yswallow/satsuma_keyboard/README.md

### Satsuma JP SMD

#### 組み立てに必要なもの
* MX互換スイッチ 67個
* ARCHISS キーキャップセット 1セット

#### 各部名称

#### 組み立て方
1. キースイッチをトッププレートにはめる。この際上下が逆になっているキーがあるので注意する。
2. キースイッチがはまった状態のトッププレートを本体にはめる。
3. キースイッチにキーキャップをはめる。
4. 完成！
