yswallow/satsuma_keyboard/docs/warranty.md

### 交換保証

購入後1ヶ月以内に故障した場合代品と交換致しますが, そちらからの送料はご負担ください。

#### 交換対象
* はんだづけされているパーツの不良によるキーが反応しなくなる症状全般

#### 除外
* トッププレートの割れ
* ファームウェアが書き換えられている場合で, はんだづけ不良が原因であると確認できない場合

#### 送付方法
~~キーキャップとキースイッチを取り外し, 動作不良のモジュールとpendantを送付ください。~~

メールでご案内します。

#### 限定
こちらでの確認でファームウェアの書き換えが原因と判明した場合, 返送料をご負担いただきます。
