yswallow/satsuma_keyboard/PCB/left/left-PCB.kicad_pcb

## KiCad design PCB/left/left-PCB.kicad_pcb (2019-07-09)

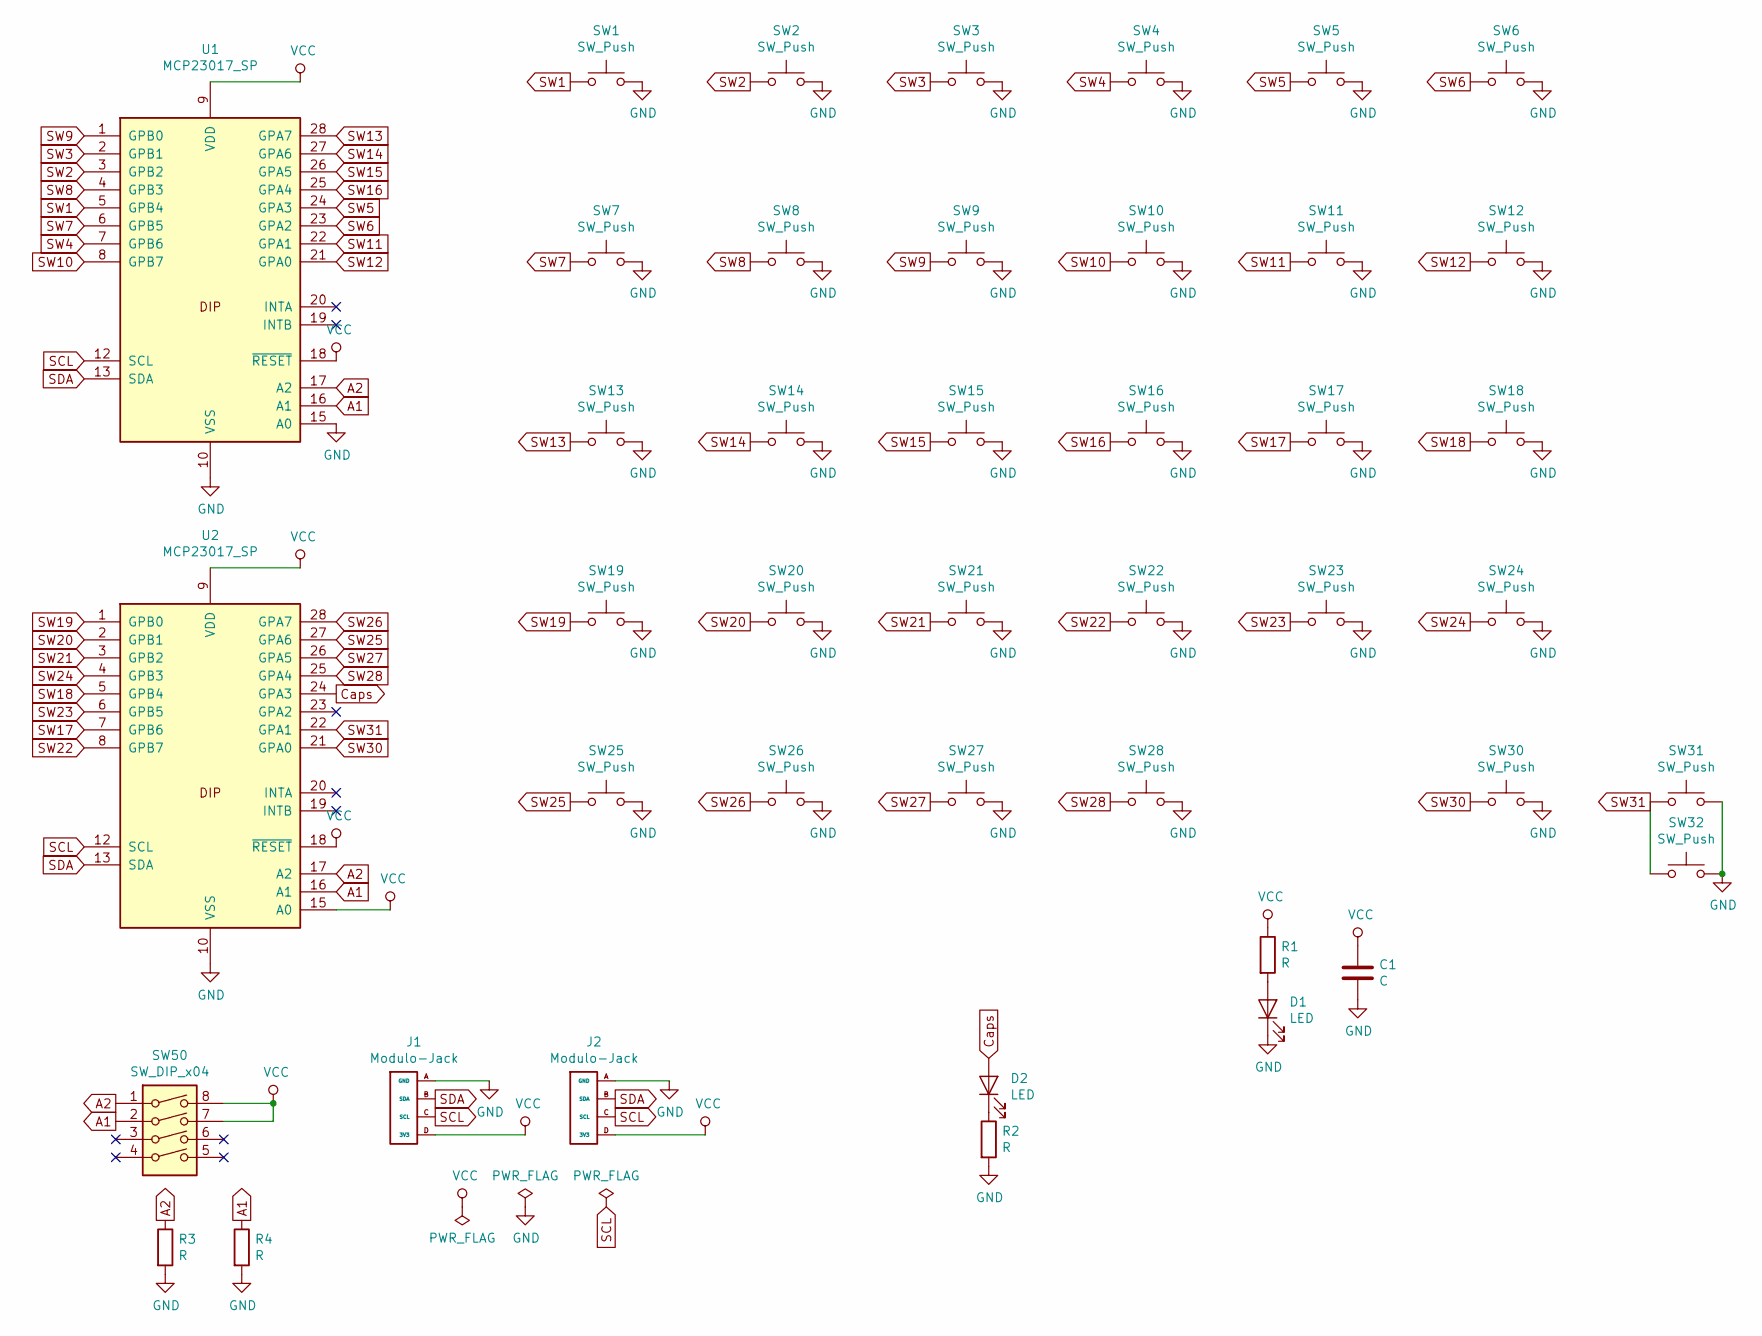
[picture p1: schematic left-PCB.sch]

Parts:
C1: C; C_2225_5664Metric_Pad1.80x6.60mm_HandSolder
D1, D2: LED; LED_D3.0mm
J1, J2: Modulo-Jack; PJ-320D
R1, R2, R3, R4: R; R_Axial_DIN0207_L6.3mm_D2.5mm_P10.16mm_Horizontal
SW1, SW2, SW3, SW4, SW5, SW6, SW8, SW9, SW10, SW11, SW12, SW14, SW15, SW16, SW17, SW18, SW20, SW21, SW22, SW23, SW24, SW26, SW28, SW30, SW31: SW_Push; MXOnly-1U-Hotswap
SW7: SW_Push; MXOnly-1.5U-Hotswap
SW13: SW_Push; MXOnly-1.75U-Hotswap
SW19: SW_Push; MXOnly-2.25U-Hotswap
SW25, SW27: SW_Push; MXOnly-1.25U-Hotswap
SW32: SW_Push; MXOnly-2U-Hotswap-ReversedStabilizers
SW50: SW_DIP_x04; KHS42
U1, U2: MCP23017_SP; SOIC-28W_7.5x17.9mm_P1.27mm

Connections:
A1: R4.1, SW50.2, U1.16 (A1), U2.16 (A1)
A2: R3.1, SW50.1, U1.17 (A2), U2.17 (A2)
Caps: D2.2 (A), U2.24 (GPA3)
GND: C1.2, D1.1 (K), J1.A (GND), J2.A (GND), R2.2, R3.2, R4.2, SW1.1, SW2.1, SW3.2, SW4.2, SW5.2, SW6.2, SW7.1, SW8.1, SW9.2, SW10.2, SW11.2, SW12.2, SW13.2, SW14.2, SW15.1, SW16.1, SW17.2, SW18.1, SW19.1, SW20.2, SW21.2, SW22.2, SW23.2, SW24.2, SW25.1, SW26.1, SW27.2, SW28.1, SW30.1, SW31.1, SW32.1, U1.10 (VSS), U1.15 (A0), U2.10 (VSS)
unnamed: D1.2 (A), R1.2
unnamed: D2.1 (K), R2.1
SCL: J1.C (SCL), J2.C (SCL), U1.12 (SCL), U2.12 (SCL)
SDA: J1.B (SDA), J2.B (SDA), U1.13 (SDA), U2.13 (SDA)
SW1: SW1.2, U1.5 (GPB4)
SW2: SW2.2, U1.3 (GPB2)
SW3: SW3.1, U1.2 (GPB1)
SW4: SW4.1, U1.7 (GPB6)
SW5: SW5.1, U1.24 (GPA3)
SW6: SW6.1, U1.23 (GPA2)
SW7: SW7.2, U1.6 (GPB5)
SW8: SW8.2, U1.4 (GPB3)
SW9: SW9.1, U1.1 (GPB0)
SW10: SW10.1, U1.8 (GPB7)
SW11: SW11.1, U1.22 (GPA1)
SW12: SW12.1, U1.21 (GPA0)
SW13: SW13.1, U1.28 (GPA7)
SW14: SW14.1, U1.27 (GPA6)
SW15: SW15.2, U1.26 (GPA5)
SW16: SW16.2, U1.25 (GPA4)
SW17: SW17.1, U2.7 (GPB6)
SW18: SW18.2, U2.5 (GPB4)
SW19: SW19.2, U2.1 (GPB0)
SW20: SW20.1, U2.2 (GPB1)
SW21: SW21.1, U2.3 (GPB2)
SW22: SW22.1, U2.8 (GPB7)
SW23: SW23.1, U2.6 (GPB5)
SW24: SW24.1, U2.4 (GPB3)
SW25: SW25.2, U2.27 (GPA6)
SW26: SW26.2, U2.28 (GPA7)
SW27: SW27.1, U2.26 (GPA5)
SW28: SW28.2, U2.25 (GPA4)
SW30: SW30.2, U2.21 (GPA0)
SW31: SW31.2, SW32.2, U2.22 (GPA1)
VCC: C1.1, J1.D (3V3), J2.D (3V3), R1.1, SW50.7, SW50.8, U1.9 (VDD), U1.18 (~RESET~), U2.9 (VDD), U2.15 (A0), U2.18 (~RESET~)

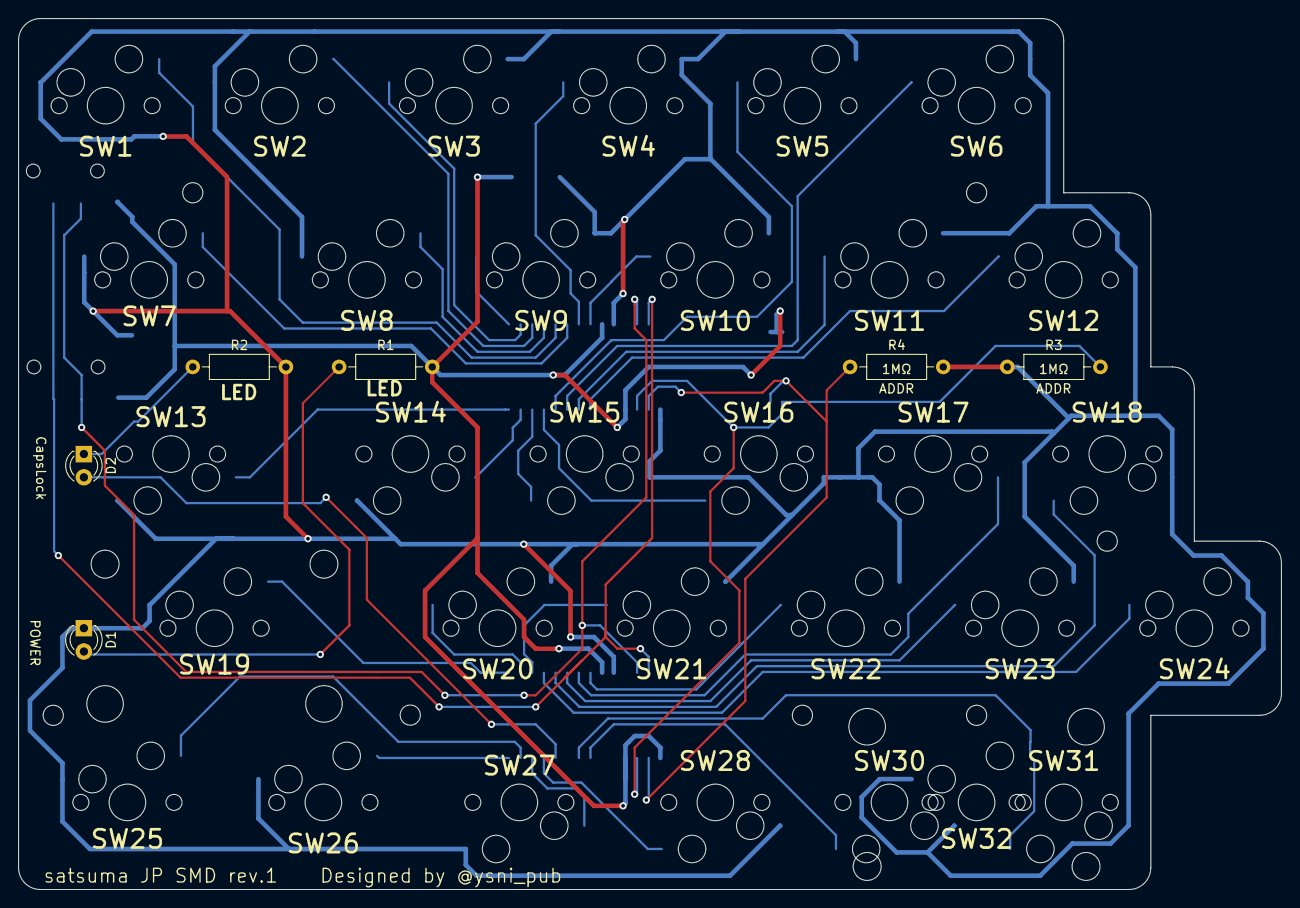
[picture p2: board left-PCB.kicad_pcb from above]

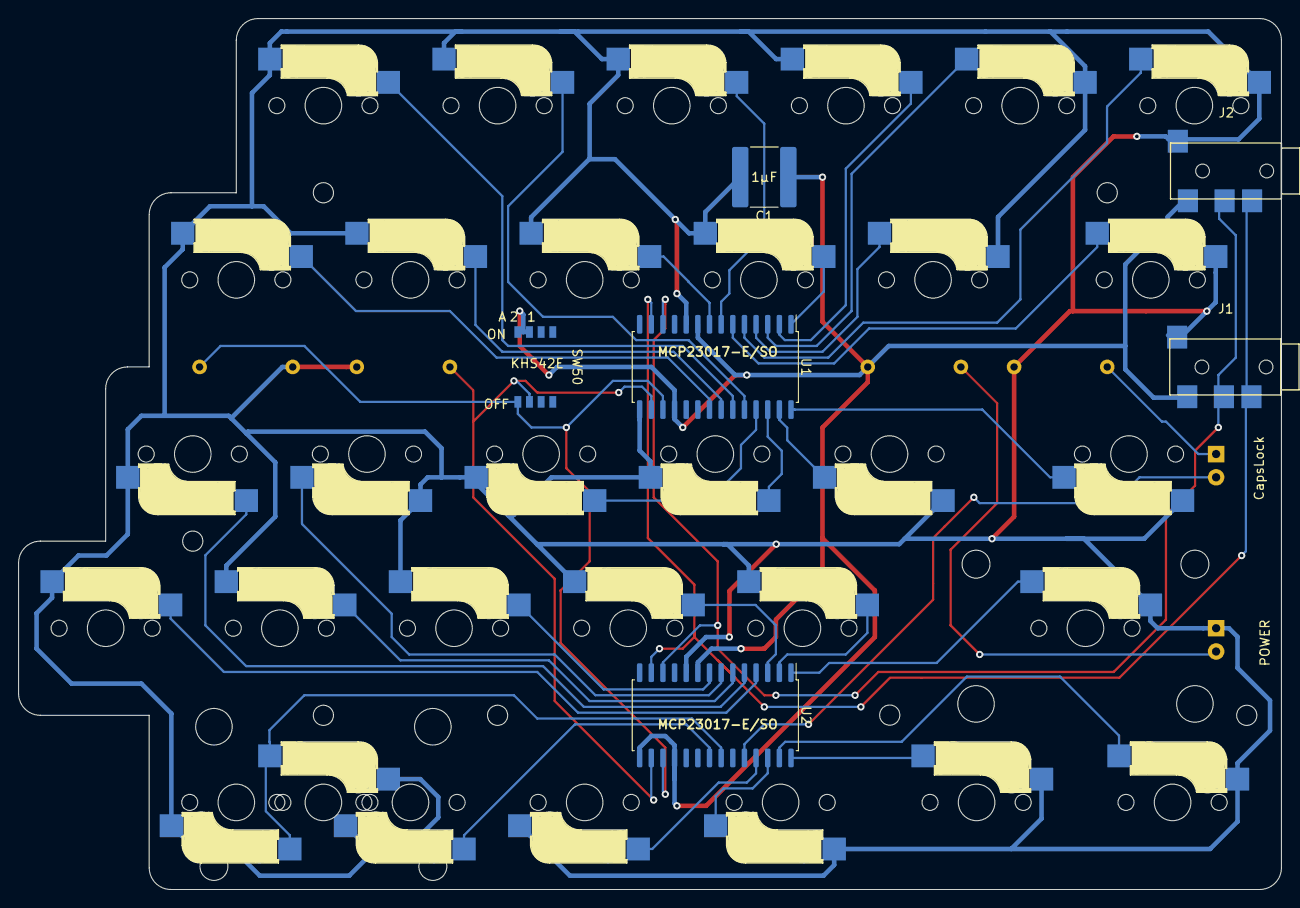
[picture p3: board left-PCB.kicad_pcb from below]

Board: 2 copper layers, 137.8 x 95.0 mm, 43 parts (6 on the bottom side), 39 nets.
