yswallow/satsuma_keyboard/PCB/right/right-PCB.kicad_pcb

## KiCad design PCB/right/right-PCB.kicad_pcb (2019-07-09)

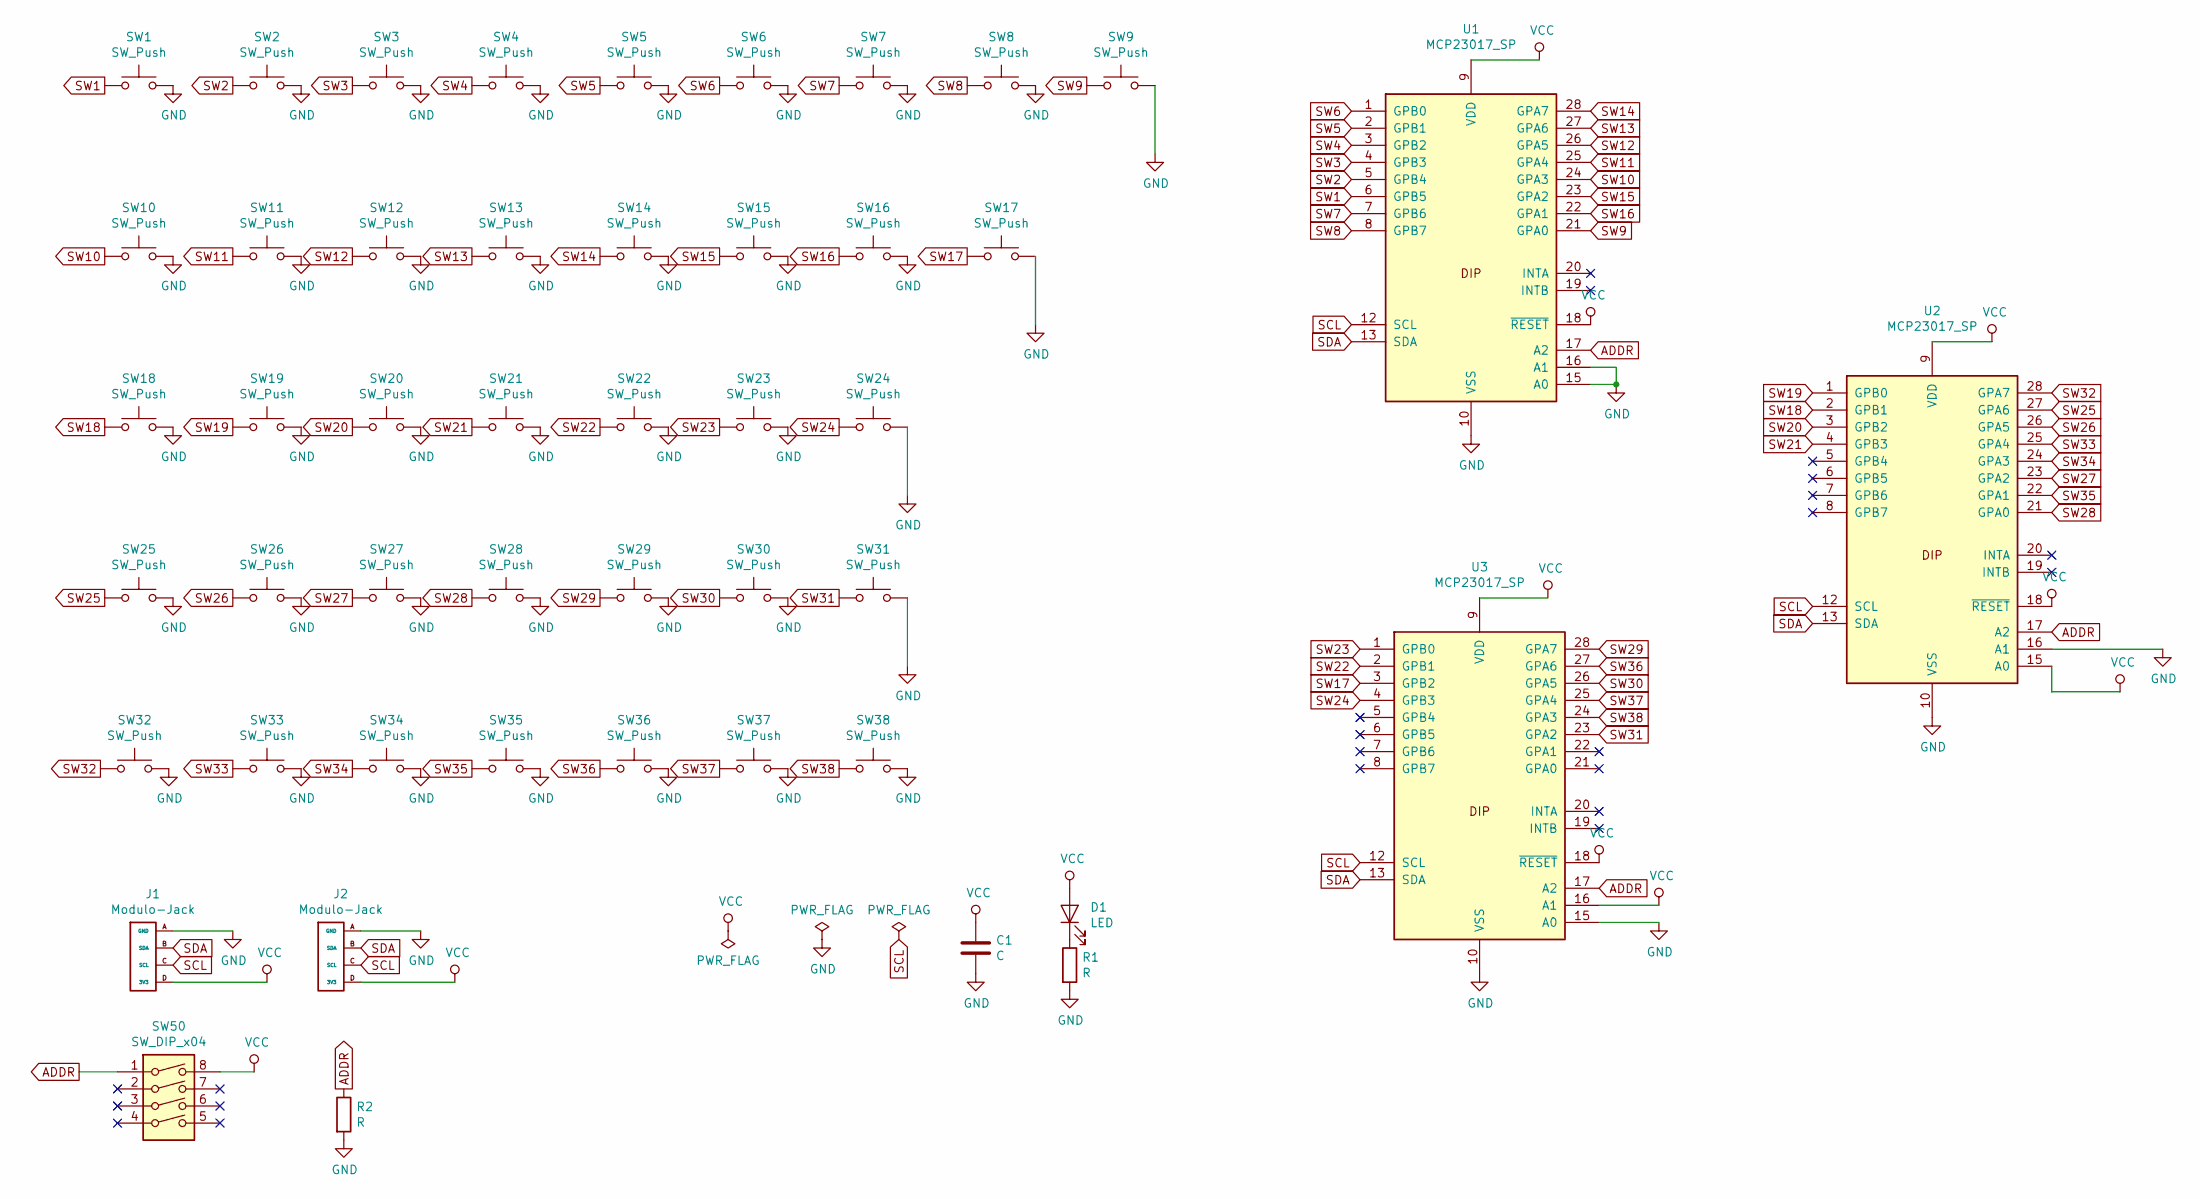
[picture p4: schematic right-PCB.sch]

Parts:
C1: C; C_2220_5650Metric_Pad1.97x5.40mm_HandSolder
D1: LED; LED_D3.0mm
J1, J2: Modulo-Jack; PJ-320D
R1, R2: R; R_Axial_DIN0207_L6.3mm_D2.5mm_P10.16mm_Horizontal
SW1, SW2, SW3, SW4, SW5, SW6, SW7, SW8, SW9, SW10, SW11, SW12, SW13, SW14, SW15, SW16, SW18, SW19, SW20, SW21, SW22, SW23, SW24, SW25, SW26, SW27, SW28, SW29, SW30, SW32, SW33, SW37: SW_Push; MXOnly-1U-Hotswap
SW17: SW_Push; MXOnly-ISO-HotSwap
SW31: SW_Push; MXOnly-1.75U-Hotswap
SW34, SW35, SW36, SW38: SW_Push; MXOnly-1.25U-Hotswap
SW50: SW_DIP_x04; KHS42
U1, U2, U3: MCP23017_SP; SOIC-28W_7.5x17.9mm_P1.27mm

Connections:
ADDR: R2.1, SW50.1, U1.17 (A2), U2.17 (A2), U3.17 (A2)
GND: C1.2, J1.A (GND), J2.A (GND), R1.2, R2.2, SW1.1, SW2.2, SW3.2, SW4.2, SW5.2, SW6.2, SW7.2, SW8.2, SW9.2, SW10.2, SW11.2, SW12.2, SW13.2, SW14.2, SW15.2, SW16.1, SW17.1, SW18.1, SW19.1, SW20.1, SW21.2, SW22.2, SW23.2, SW24.2, SW25.2, SW26.2, SW27.1, SW28.1, SW29.2, SW30.1, SW31.2, SW32.1, SW33.1, SW34.2, SW35.2, SW36.2, SW37.2, SW38.1, U1.10 (VSS), U1.15 (A0), U1.16 (A1), U2.10 (VSS), U2.16 (A1), U3.10 (VSS), U3.15 (A0)
unnamed: D1.1 (K), R1.1
SCL: J1.C (SCL), J2.C (SCL), U1.12 (SCL), U2.12 (SCL), U3.12 (SCL)
SDA: J1.B (SDA), J2.B (SDA), U1.13 (SDA), U2.13 (SDA), U3.13 (SDA)
SW1: SW1.2, U1.6 (GPB5)
SW2: SW2.1, U1.5 (GPB4)
SW3: SW3.1, U1.4 (GPB3)
SW4: SW4.1, U1.3 (GPB2)
SW5: SW5.1, U1.2 (GPB1)
SW6: SW6.1, U1.1 (GPB0)
SW7: SW7.1, U1.7 (GPB6)
SW8: SW8.1, U1.8 (GPB7)
SW9: SW9.1, U1.21 (GPA0)
SW10: SW10.1, U1.24 (GPA3)
SW11: SW11.1, U1.25 (GPA4)
SW12: SW12.1, U1.26 (GPA5)
SW13: SW13.1, U1.27 (GPA6)
SW14: SW14.1, U1.28 (GPA7)
SW15: SW15.1, U1.23 (GPA2)
SW16: SW16.2, U1.22 (GPA1)
SW17: SW17.2, U3.3 (GPB2)
SW18: SW18.2, U2.2 (GPB1)
SW19: SW19.2, U2.1 (GPB0)
SW20: SW20.2, U2.3 (GPB2)
SW21: SW21.1, U2.4 (GPB3)
SW22: SW22.1, U3.2 (GPB1)
SW23: SW23.1, U3.1 (GPB0)
SW24: SW24.1, U3.4 (GPB3)
SW25: SW25.1, U2.27 (GPA6)
SW26: SW26.1, U2.26 (GPA5)
SW27: SW27.2, U2.23 (GPA2)
SW28: SW28.2, U2.21 (GPA0)
SW29: SW29.1, U3.28 (GPA7)
SW30: SW30.2, U3.26 (GPA5)
SW31: SW31.1, U3.23 (GPA2)
SW32: SW32.2, U2.28 (GPA7)
SW33: SW33.2, U2.25 (GPA4)
SW34: SW34.1, U2.24 (GPA3)
SW35: SW35.1, U2.22 (GPA1)
SW36: SW36.1, U3.27 (GPA6)
SW37: SW37.1, U3.25 (GPA4)
SW38: SW38.2, U3.24 (GPA3)
VCC: C1.1, D1.2 (A), J1.D (3V3), J2.D (3V3), SW50.8, U1.9 (VDD), U1.18 (~RESET~), U2.9 (VDD), U2.15 (A0), U2.18 (~RESET~), U3.9 (VDD), U3.16 (A1), U3.18 (~RESET~)

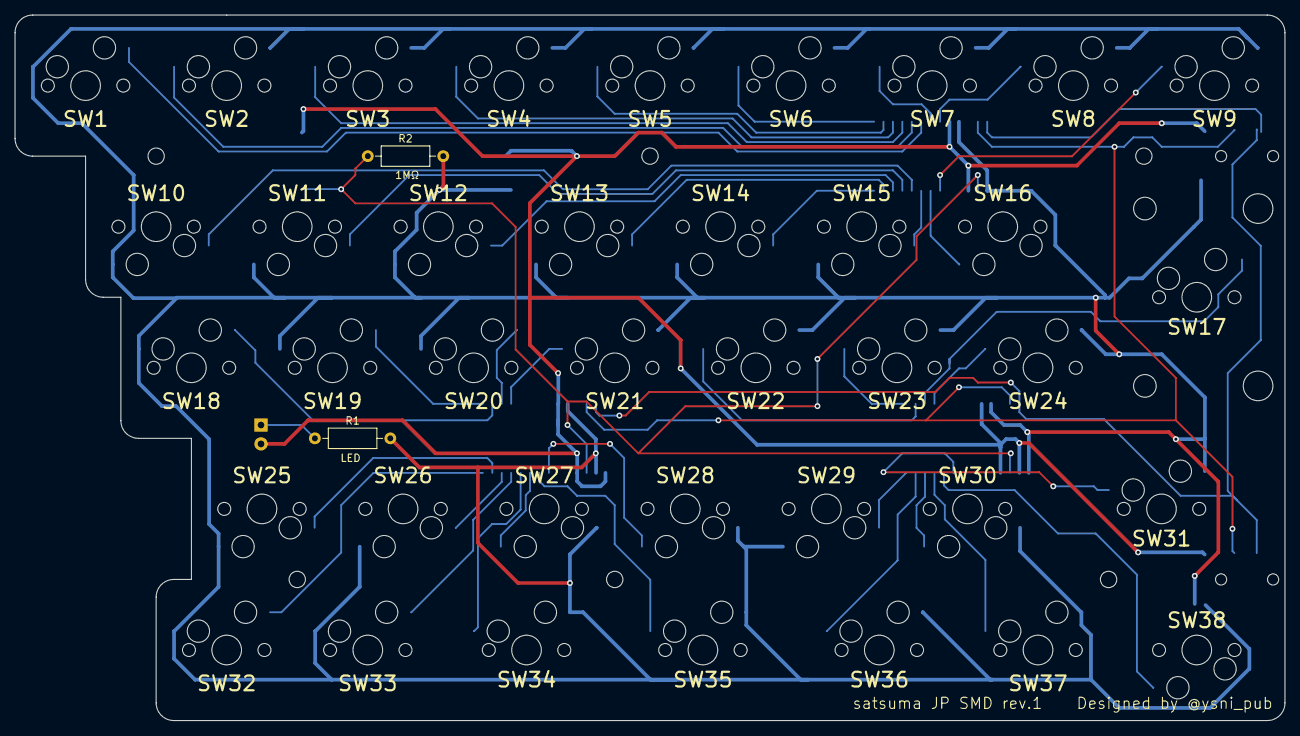
[picture p5: board right-PCB.kicad_pcb from above]

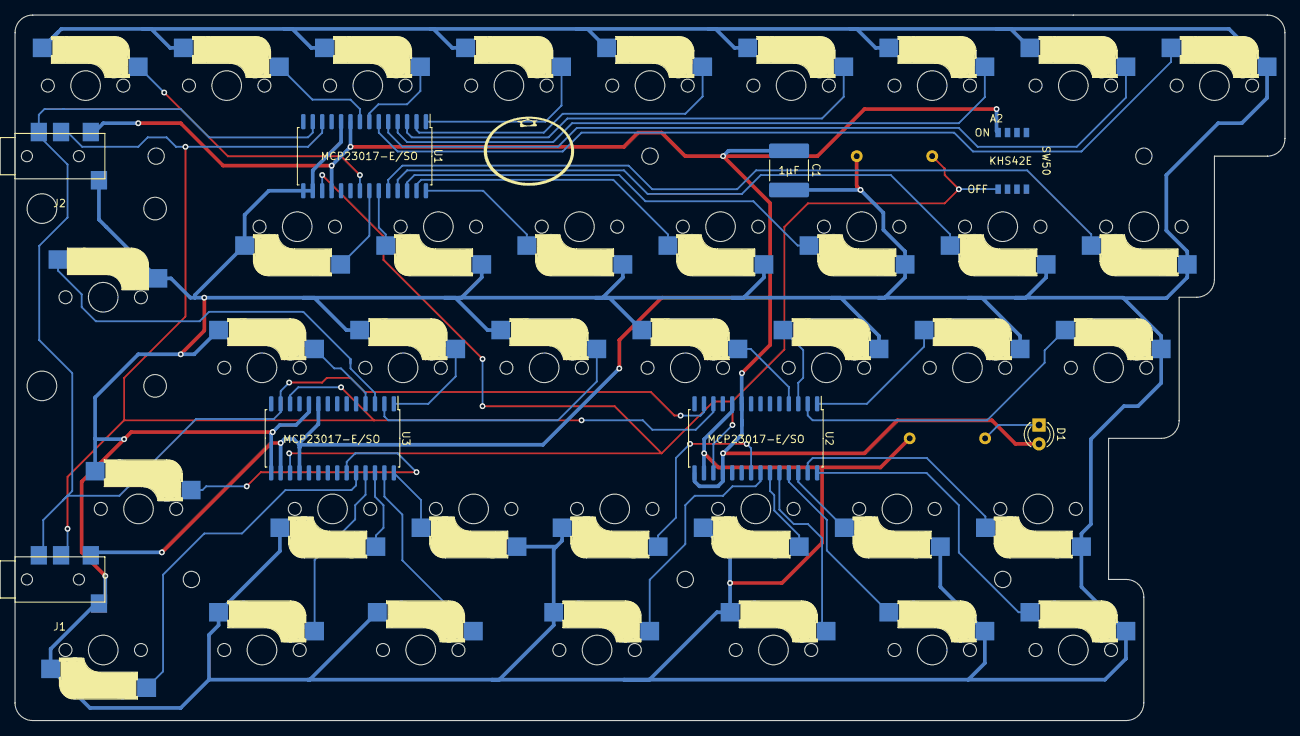
[picture p6: board right-PCB.kicad_pcb from below]

Board: 2 copper layers, 171.0 x 95.0 mm, 48 parts (8 on the bottom side), 44 nets.
