yswallow/satsuma_keyboard/left/left.kicad_pcb

## KiCad design left/left.kicad_pcb (2019-06-07)

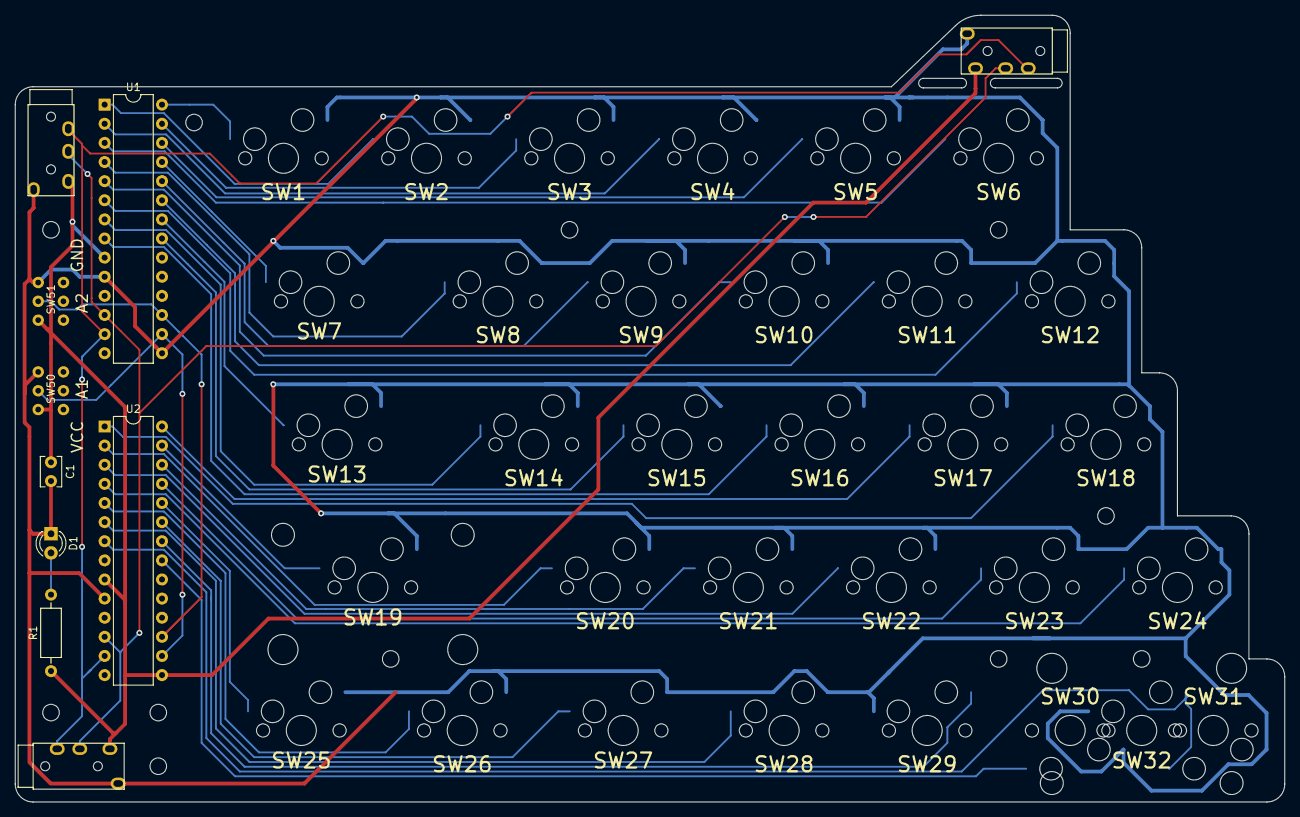
[picture p7: board left.kicad_pcb from above]

Board: 2 copper layers, 168.6 x 104.5 mm, 42 parts (0 on the bottom side), 38 nets.

Parts:
C1: C; C_Disc_D3.8mm_W2.6mm_P2.50mm
D1: LED; LED_D3.0mm
J1, J2, J3: Modulo-Jack; MJ-4PP-9
R1: R; R_Axial_DIN0207_L6.3mm_D2.5mm_P10.16mm_Horizontal
SW1, SW2, SW3, SW4, SW5, SW6, SW8, SW9, SW10, SW11, SW12, SW14, SW15, SW16, SW17, SW18, SW20, SW21, SW22, SW23, SW24, SW26, SW28, SW29, SW30, SW31: SW_Push; MXOnly-1U-Hotswap
SW7: SW_Push; MXOnly-1.5U-Hotswap
SW13: SW_Push; MXOnly-1.75U-Hotswap
SW19: SW_Push; MXOnly-2.25U-Hotswap
SW25, SW27: SW_Push; MXOnly-1.25U-Hotswap
SW32: SW_Push; MXOnly-2U-Hotswap-ReversedStabilizers
SW50, SW51: SW_DPDT_x2; SlideSwitch_IS2235
U1, U2: MCP23017_SP; DIP-28_W7.62mm

Connections:
A1: SW50.2, U1.16, U2.16
A2: SW51.2, U1.17, U2.17
GND: C1.2, D1.1, J1.A, J2.A, J3.A, SW1.2, SW2.2, SW3.2, SW4.2, SW5.2, SW6.2, SW7.2, SW8.2, SW9.2, SW10.2, SW11.2, SW12.2, SW13.2, SW14.2, SW15.2, SW16.2, SW17.2, SW18.2, SW19.2, SW20.2, SW21.2, SW22.2, SW23.2, SW24.2, SW25.2, SW26.2, SW27.2, SW28.2, SW29.1, SW30.1, SW31.1, SW32.1, SW50.3, SW51.3, U1.10, U1.15, U2.10
unnamed: D1.2, R1.2
SCL: J1.C, J2.C, J3.C, U1.12, U2.12
SDA: J1.B, J2.B, J3.B, U1.13, U2.13
SW1: SW1.1, U1.28
SW2: SW2.1, U1.1
SW3: SW3.1, U1.27
SW4: SW4.1, U1.2
SW5: SW5.1, U1.26
SW6: SW6.1, U1.3
SW7: SW7.1, U1.25
SW8: SW8.1, U1.4
SW9: SW9.1, U1.24
SW10: SW10.1, U1.5
SW11: SW11.1, U1.23
SW12: SW12.1, U1.6
SW13: SW13.1, U1.22
SW14: SW14.1, U1.7
SW15: SW15.1, U1.21
SW16: SW16.1, U1.8
SW17: SW17.1, U2.28
SW18: SW18.1, U2.1
SW19: SW19.1, U2.27
SW20: SW20.1, U2.2
SW21: SW21.1, U2.26
SW22: SW22.1, U2.3
SW23: SW23.1, U2.25
SW24: SW24.1, U2.4
SW25: SW25.1, U2.24
SW26: SW26.1, U2.5
SW27: SW27.1, U2.23
SW28: SW28.1, U2.6
SW29: SW29.2, U2.22
SW30: SW30.2, U2.21
SW31: SW31.2, SW32.2, U2.7
VCC: C1.1, J1.D, J2.D, J3.D, R1.1, SW50.1, SW51.1, U1.9, U2.9, U2.15
