yswallow/satsuma_keyboard/right/right.kicad_pcb

## KiCad design right/right.kicad_pcb (2019-06-06)

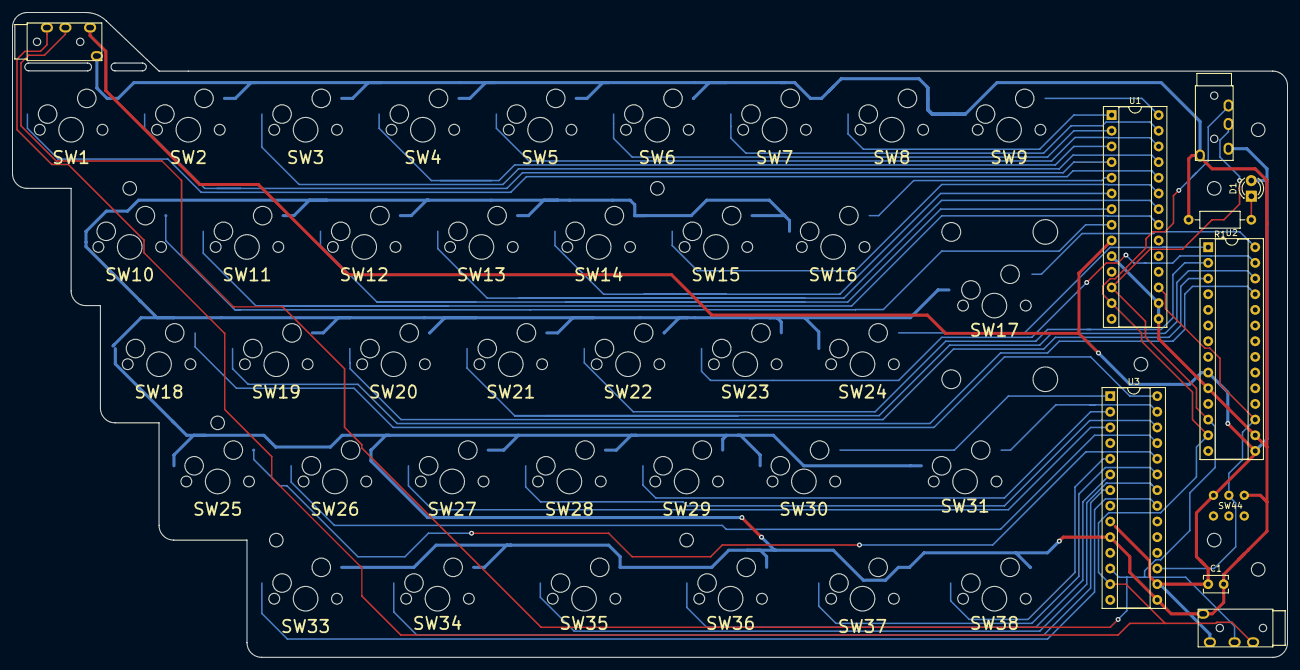
[picture p8: board right.kicad_pcb from above]

Board: 2 copper layers, 206.6 x 104.5 mm, 47 parts (0 on the bottom side), 43 nets.

Parts:
C1: C; C_Disc_D3.8mm_W2.6mm_P2.50mm
D1: LED; LED_D3.0mm
J1, J2, J3: Modulo-Jack; MJ-4PP-9
R1: R; R_Axial_DIN0207_L6.3mm_D2.5mm_P10.16mm_Horizontal
SW1, SW2, SW3, SW4, SW5, SW6, SW7, SW8, SW9, SW10, SW11, SW12, SW13, SW14, SW15, SW16, SW18, SW19, SW20, SW21, SW22, SW23, SW24, SW25, SW26, SW27, SW28, SW29, SW30, SW33, SW37: SW_Push; MXOnly-1U-Hotswap
SW17: SW_Push; MXOnly-ISO-HotSwap
SW31: SW_Push; MXOnly-1.75U-Hotswap
SW34, SW35, SW36, SW38: SW_Push; MXOnly-1.25U-Hotswap
SW44: SW_DPDT_x2; SlideSwitch_IS2235
U1, U2, U3: MCP23017_SP; DIP-28_W7.62mm_Socket

Connections:
ADDR: SW44.2, U1.17, U2.17, U3.17
GND: C1.2, J1.A, J2.A, J3.A, R1.2, SW1.2, SW2.2, SW3.2, SW4.2, SW5.2, SW6.2, SW7.2, SW8.2, SW9.1, SW10.1, SW11.2, SW12.2, SW13.2, SW14.2, SW15.2, SW16.1, SW17.1, SW18.1, SW19.2, SW20.2, SW21.2, SW22.2, SW23.2, SW24.1, SW25.1, SW26.2, SW27.2, SW28.2, SW29.2, SW30.1, SW31.1, SW33.2, SW34.2, SW35.2, SW36.2, SW37.2, SW38.2, SW44.3, U1.10, U1.15, U1.16, U2.10, U2.16, U3.10, U3.15
unnamed: D1.1, R1.1
SCK: J1.C, J2.C, J3.C, U1.12, U2.12, U3.12
SDA: J1.B, J2.B, J3.B, U1.13, U2.13, U3.13
SW1: SW1.1, U1.24
SW2: SW2.1, U1.4
SW3: SW3.1, U1.25
SW4: SW4.1, U1.3
SW5: SW5.1, U1.26
SW6: SW6.1, U1.2
SW7: SW7.1, U1.27
SW8: SW8.1, U1.1
SW9: SW9.2, U1.28
SW10: SW10.2, U1.8
SW11: SW11.1, U1.21
SW12: SW12.1, U1.7
SW13: SW13.1, U1.22
SW14: SW14.1, U1.6
SW15: SW15.1, U1.23
SW16: SW16.2, U1.5
SW17: SW17.2, U2.28
SW18: SW18.2, U3.28
SW19: SW19.1, U2.25
SW20: SW20.1, U2.3
SW21: SW21.1, U2.26
SW22: SW22.1, U2.2
SW23: SW23.1, U2.27
SW24: SW24.2, U2.1
SW25: SW25.2, U3.24
SW26: SW26.1, U3.25
SW27: SW27.1, U3.3
SW28: SW28.1, U3.26
SW29: SW29.1, U3.2
SW30: SW30.2, U3.1
SW31: SW31.2, U3.27
SW33: SW33.1, U3.21
SW34: SW34.1, U3.7
SW35: SW35.1, U3.22
SW36: SW36.1, U3.6
SW37: SW37.1, U3.23
SW38: SW38.1, U3.5
VCC: C1.1, D1.2, J1.D, J2.D, J3.D, SW44.1, U1.9, U2.9, U2.15, U3.9, U3.16
