yswallow/satsuma_keyboard/docs/buildguide.md

### パーツ
#### 電子部品
* MCP23017-E/SO ×5
* 抵抗 1/6W 1MΩ ×3
* 抵抗 1/6W 4.7kΩ ×3 (抵抗値は1kΩ〜10kΩ程度ならどれでも良い)
* 表面実装DIPスイッチ KHS42E ×2
* 表面実装コンデンサ 5750 1μF ×2
* 表面実装ジャック PJ320D ×4
* 薄型LED(厚さ2mm以内) ×3

#### キーボードパーツ(配列による)
* Kailh MXスイッチソケット ×67〜68
* MX互換スイッチ ×ソケットと同数
* スタビライザー ×2〜3

#### ネジ・スペーサー・ナット
* ネジ M2×8mm ×10
* スペーサー M2×3mm ×10
* ナット M2 ×10
