yswallow/satsuma_keyboard/docs/troubleshooting.md

### トラブルシューティング

#### まずすること
* pendantを一度PCから抜き, 挿し直す

#### 約10秒ごとに"I2C slave device not found"と入力される
TRRSケーブルが抜けている/接触不良です

#### 全てのキーが入力できない
* pendantにTRRSケーブルは接続されていますか?
* pendantはPCに接続されていますか? 
* アドレスは正しいですか?

#### 複数のキーが入力できない
MCP23017が認識されていない可能性があります

#### 1つのキーが入力できない
MCP23017の該当するピン, もしくはソケットのはんだが不良となっている可能性があります。

#### 新しいモジュールを追加したら一部のキーが反応しなくなった
アドレスが衝突しています。スイッチを確認してください。

#### 一部のキーが正しく入力されない(CapsLockがCtrlになる, 円マーク(\)がBackSpaceになる等)
一度pendantを抜き, スペースキー(複数ある場合どれでも良い)とBackSpaceを(円マークと入れ替わっている場合も元々BackSpaceだったキーを)押したままpendantをPCに再接続してください。
