yswallow/satsuma_keyboard/(commit log)

2019-06-05 left: change address switch to DPDT
    [left.kicad_pcb, left.sch]
2019-06-05 left: ネジ穴を再生
    [left.kicad_pcb]
2019-06-06 last commit
    [left.kicad_pcb, left.sch, right.kicad_pcb, right.sch]
2019-06-06 modify left to JIS layout
    [left.kicad_pcb, left.sch]
2019-06-06 modify right to JIS layout
    [right.kicad_pcb, right.sch]
2019-06-06 modify mounting holl
    [left.kicad_pcb]
2019-06-07 add left plate data
    [left.kicad_pcb]
2019-06-07 move screw
    [left.kicad_pcb]
2019-07-09 add sign
    [left-PCB.kicad_pcb, left-bottom.kicad_pcb, right-PCB.kicad_pcb]
2019-07-09 add silk
    [left-PCB.kicad_pcb, right-PCB.kicad_pcb]
2019-07-09 change TRRS jack footprint to PJ-320D
    [left-PCB.kicad_pcb, left-PCB.sch, right-PCB.kicad_pcb, right-PCB.sch]
2019-07-09 cutout TRRS jack place
    [left-bottom.kicad_pcb, right-bottom.kicad_pcb]
2019-07-09 shlink cutout
    [left-bottom.kicad_pcb, right-bottom.kicad_pcb]
2019-07-09 change stabilizer cutout
    [left-top.kicad_pcb, right-top.kicad_pcb]
2019-07-09 move right drillhole
    [right-PCB.kicad_pcb, right-bottom.kicad_pcb, right-top.kicad_pcb]
2019-07-09 move screw holl
    [left-PCB.kicad_pcb, left-bottom.kicad_pcb, left-top.kicad_pcb, right-PCB.kicad_pcb, right-bottom.kicad_pcb, right-top.kicad_pcb]
2019-07-09 rev1 release
    [left-PCB-B_Cu.gbl, left-PCB-B_Mask.gbs, left-PCB-B_SilkS.gbo, left-PCB-Edge_Cuts.gm1, left-PCB-F_Cu.gtl, left-PCB-F_Mask.gts, left-PCB-F_SilkS.gto, left-PCB-NPTH.drl]
